metras13/EGBLE/app/src/components/ware1.png

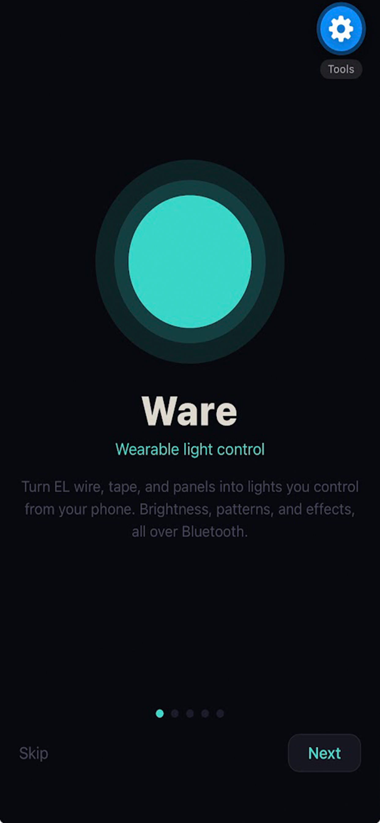
app/src/components/ware1.png
