metras13/EGBLE/app/src/components/ware2.png

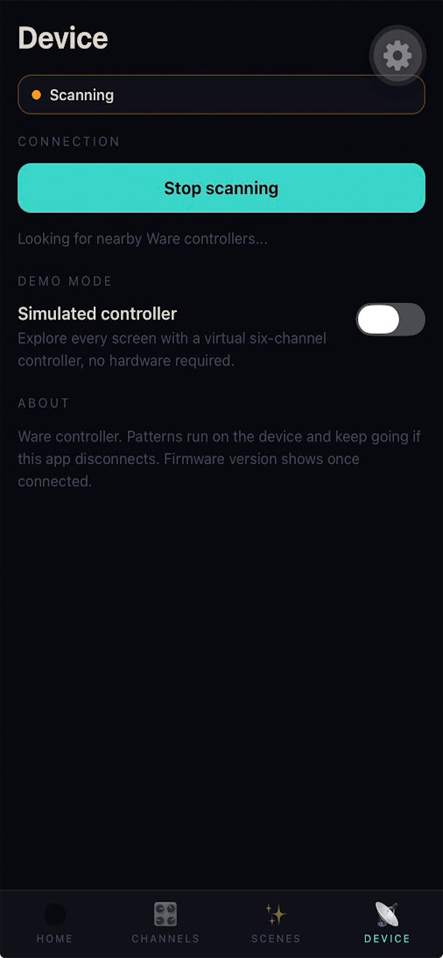
app/src/components/ware2.png
