metras13/EGBLE/app/src/components/ware3.png

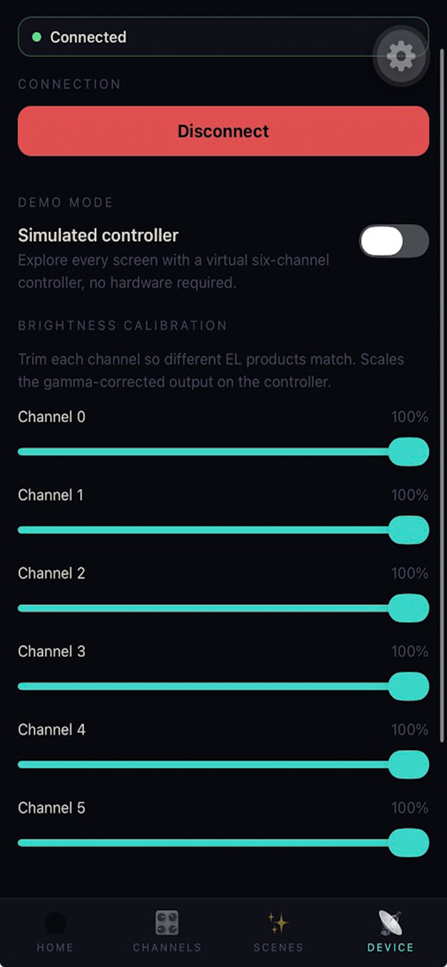
app/src/components/ware3.png
