metras13/EGBLE/app/src/components/ware4.png

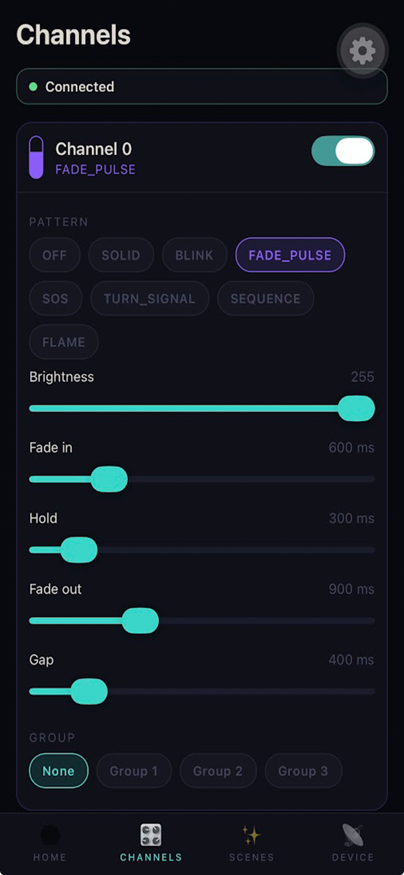
app/src/components/ware4.png
