metras13/EGBLE/app/src/components/ware5.png

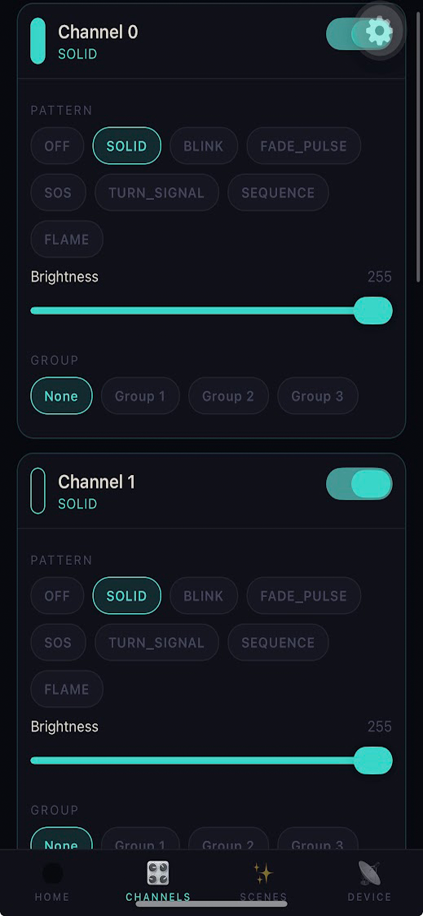
app/src/components/ware5.png
