metras13/EGBLE/app/src/components/ware6.png

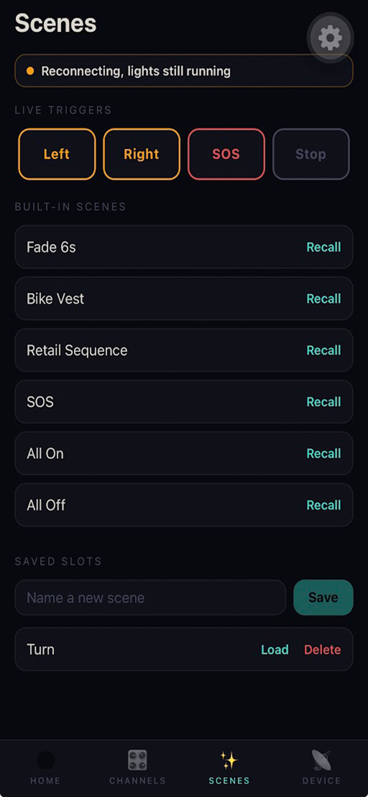
app/src/components/ware6.png
