metras13/EGBLE/(commit log)

2026-07-10 Initial commit: EGBLE 6-channel EL inverter controller
    Firmware (Arduino-ESP32, ESP32-C3-Zero), React Native (Expo) BLE app, and
    hardware/protocol docs for the 6-channel EL inverter dimmer/controller.
    Firmware (Phases 1-4):
    - LEDC 10-bit PWM channel driver with mandatory gamma correction and a
    per-channel calibration scale
    - Data-driven pattern engine: OFF, SOLID, BLINK, FADE_PULSE, SOS,
    TURN_SIGNAL, SEQUENCE, each a non-blocking per-channel state machine
    - Runtime channel enable/disable and grouping; SEQUENCE chases a group
    - Scene system persisted to NVS with five built-ins
    - BLE GATT service (command/state/scene) over NimBLE, compact JSON protocol
    - USB serial console for bench testi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
    [BleService.cpp, BleService.h, Channel.cpp, Channel.h, Pattern.cpp, Pattern.h, PatternEngine.cpp, PatternEngine.h]
2026-07-10 Add root .gitignore
    Ignore OS, editor, Python bytecode, and Arduino build artifacts at the repo
    root. The app keeps its own .gitignore for node/Expo output.
    Claude-Session: https://claude.ai/code/session_01FUi6Qdqy98eBmAS2bnUoQV
2026-07-10 Add Fade 6s bench test: 6s on-to-off fade, boot default, runbook
    First bench-bring-up target: a six second fade on to off on the real
    inverter.
    Firmware:
    - New "Fade 6s" built-in scene: every channel snaps to full and fades to off
    over 6000 ms through the gamma ramp, repeating. Confirms PWM, gamma, MOSFET
    and inverter together.
    - Board now boots into Fade 6s so the first bench test needs no phone. Also
    surfaces automatically as the first built-in in the app's Scenes list and is
    triggerable over serial with the new `fade` command.
    App:
    - Add eas.json with a development-client build profile so the app can be sent
    to Expo / EAS for on-device testing.
    Docs:
    - docs/bench-bringup.md: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
    [Scenes.cpp, SerialConsole.cpp, egble-controller.ino]
2026-07-10 Add single-channel bench wiring diagram
    SVG showing the Stage 1 wiring: ESP32 GPIO3 to the MOSFET gate through a
    100 ohm resistor, 10k gate-to-ground pulldown, low-side switching of the
    inverter ground return, and the common ground tying the bench supply,
    MOSFET source, pulldown and ESP32 together. Referenced from the bench
    bring-up runbook.
    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
2026-07-10 Document ESP32-C3 SuperMini compatibility
    The build is pin-compatible with both the Waveshare C3-Zero and the Teyleten /
    generic C3 SuperMini: all six PWM pins (3,4,5,6,7,10) and the trigger pin (1)
    are broken out on both, and the avoided strapping pins happen to be the
    SuperMini's onboard LED (GPIO8) and BOOT button (GPIO9). Note the SuperMini
    download-mode key combo for flashing and its weaker antenna. No pin changes.
    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
    [config.h]
2026-07-11 Document FQP30N06L as the verified bench MOSFET
    Capture the logic-level TO-220 option the build is using: FQP30N06L (60V/32A,
    hugely overrated for an EL inverter so it runs cold, and easier to hand-wire
    than SOT-23). Records the TO-220 pinout (1=Gate, 2=Drain and tab, 3=Source) in
    the BOM, per-channel circuit notes, bench runbook, and wiring diagram. Also
    loosen the gate pulldown spec to 10k-47k so an on-hand 12.5k qualifies.
    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
2026-07-11 Document powering the ESP32
    Add a "Powering the ESP32" subsection to the power path notes: bench setup
    (ESP32 on USB, inverters on the bench supply, common ground), the two options
    for a finished build (own USB vs sharing the 5V rail into the SuperMini 5V pin),
    and the one-source-at-a-time gotcha (USB 5V and the 5V pin are tied on most
    SuperMini boards, so do not power both at once).
    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
2026-07-11 Fix build: include <stddef.h> in Scenes.h for size_t
    Scenes.h declares slotName(..., size_t) but only included <stdint.h>, so
    size_t was undeclared when the header was pulled in ahead of any stddef,
    breaking the Arduino build with "'size_t' has not been declared". Include
    <stddef.h> directly in the header that uses it.
    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
    [Scenes.h]
2026-07-11 Fix BLE crash loop: migrate to NimBLE-Arduino 2.x API
    On esp32 core 3.x, pairing the firmware with NimBLE 1.4.x links but panics at
    boot: the BLE controller and host disagree on version ("fadebead VERSION"
    mismatch) and the board hits an instruction access fault in a reboot loop.
    Move BleService to the NimBLE 2.x API, which is the line that matches core 3.x:
    - Callback signatures take NimBLEConnInfo (onWrite) and NimBLEConnInfo + reason
    (onConnect/onDisconnect).
    - setScanResponse renamed to enableScanResponse.
    - Drop the setPower(ESP_PWR_LVL_*) call; 2.x takes dBm, and the default is fine.
    Docs and the sketch header now specify NimBLE-Arduino 2.x and explain the crash
    signature so it is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
    [BleService.cpp, egble-controller.ino]
2026-07-11 Make Fade 6s a symmetric breathe (3s up, 3s down)
    Bench-verified the snap-on plus fade-out worked; switch the default bench scene
    to a symmetric breathe so the gamma ramp is checked in both directions. Six
    second cycle: fadeInMs 3000, fadeOutMs 3000. Docs updated to match.
    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
2026-07-11 Advertise the BLE name explicitly; record measured inverter current
    NimBLE-Arduino 2.x does not auto-add the device name to the advertisement the
    way 1.4.x did, so the controller was advertising its service UUID but no
    readable name and did not show as "EGBLE-Controller" in scanners. Call
    NimBLEAdvertising::setName so the name lands in the scan response (the 128-bit
    service UUID already fills the primary advertising packet).
    Also record the Phase 1 bench measurement in the BOM: about 40 mA per inverter
    at peak, ~0 mA off, so roughly 240 mA for six channels and a 5V 1A supply is
    ample.
    Claude-Session: https://claude.ai/code/session_01F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
2026-07-11 Fix EAS install: pin react-dom to react's version
    npm floated react-dom to 19.2.7 (pulled in transitively via expo-router web
    deps), which demands react ^19.2.7 while the project pins react 19.2.0, so EAS
    `npm ci` failed with ERESOLVE. Pin react-dom to 19.2.0 to match react (its peer
    is react ^19.2.0, satisfied), and add app/.npmrc with legacy-peer-deps=true as a
    safety net against future transitive peer drift on the strict CI install. The
    app is iOS-only, so react-dom is not used at runtime regardless.
    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
2026-07-11 Force react-dom to 19.2.0 with an npm override
    The direct react-dom pin was not enough on its own because EAS runs `npm ci`,
    which installs from the committed package-lock.json and ignores package.json.
    Add an "overrides" entry so react-dom resolves to 19.2.0 tree-wide whenever the
    lockfile is regenerated, defeating the transitive pull of react-dom 19.2.7 from
    expo-router's web deps. The lockfile still has to be regenerated and committed
    for npm ci to pick it up.
    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
2026-07-11 Commit verified package-lock.json (react-dom pinned 19.2.0)
    Generate and commit the lockfile so EAS `npm ci` installs a known-good tree
    instead of re-resolving react-dom to 19.2.7. Verified in a clean environment:
    `npm ci --dry-run --legacy-peer-deps=false` (strict peer resolution, the EAS
    worst case) succeeds with no ERESOLVE, and react-dom resolves to 19.2.0.
    Pull this branch and rebuild; no local regeneration needed.
    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
2026-07-11 Add 6-channel wiring guide and Phase 3 bring-up checklist
    Bus-style diagram (docs/wiring-6-channel.svg): one shared 5V supply and one
    common ground feeding six repeats of the proven single-channel block on GPIO
    3/4/5/6/7/10. Add a Stage 3 checklist to the bench runbook covering the pin map,
    supply sizing (~240 mA), grouping/SEQUENCE test commands, and what to watch for
    (EMI/brownout with all six switching). No firmware changes needed; six channels,
    grouping and SEQUENCE are already supported.
    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
2026-07-11 Rebrand to Ware; add Orb home with presets and a Channels tab
    Ware (a play on "wear", for wearables) is the app-facing brand; the BLE device
    name and repo stay EGBLE to avoid a reflash.
    - New Home screen: a large orb as the master control (tap to turn on/off), a
    brightness slider to dim, and Steady/Flame/Strobe/Fade presets each with a
    speed slider. Flame maps to the new FLAME pattern, Strobe to BLINK, Fade to
    FADE_PULSE. Orb state is derived from device notifications, not local guesses.
    - Move the per-channel dashboard to its own Channels tab; tabs are now
    Home / Channels / Scenes / Device.
    - Store: add persisted masterBrightness, channelCount, and onboarded prefs plus
    a setAllPa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
2026-07-13 Fix EL fade-in pop with a calibrated output floor
    EL inverters start oscillating at a higher drive than they sustain (measured on
    this inverter: start ~187, sustain ~145 of 1023). Below the start threshold a
    fade-in stays dark then pops on, while fade-out stays lit down to the lower
    sustain level and looks smooth. Same ramp, asymmetric light.
    Remap any lit output into [OUTPUT_FLOOR_DUTY, PWM_MAX_DUTY] (floor default 200,
    just above the measured start threshold) in Channel::setBrightness, preserving
    the gamma shape. The dimmest visible drive now clears the start threshold, so
    fade-ins begin just-visible and ramp smoothly. Level 0 stays fully off. The
    floor is a config constant, tunable per i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
    [Channel.cpp, config.h]
2026-07-13 Tune fade-in for EL: gamma 2.0 and a slightly lower output floor
    The fade-in still held dim then rushed up because gamma 2.2 is calibrated for
    LEDs (linear duty-to-brightness), while EL inverters brighten steeply near the
    threshold then flatten. Regenerate the gamma table at 2.0 (softer low end) so a
    linear level ramp reads as an even fade on EL, and lower OUTPUT_FLOOR_DUTY from
    200 to 195 so the ramp starts a touch dimmer while still clearing the 187 start
    threshold. Both are documented as tunable dials: gamma via gen_gamma.py, floor
    in config.h.
    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
2026-07-14 Clarify 6-channel wiring: drains are separate from the common ground
    The original 6-channel diagram made all six drops converge at the bottom, which
    reads as "all grounds tied together" and led to inverter V- returns being landed
    on the common ground rail, bypassing the MOSFETs and leaving every channel stuck
    on. Redraw so each inverter V- to MOSFET drain segment is a distinct color
    (orange, switched return, one node per channel) versus the black common ground
    (sources + supply minus + ESP32 GND only), add V+/V-/D/S labels, and a bold
    warning that drains must never touch the ground rail or each other. Same warning
    added to the Phase 3 checklist.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
2026-07-27 Package Ware for App Store submission
    Production app config and assets:
    - App icon (1024, glowing teal orb on dark, matching the Home orb), Android
    adaptive icon, and a dark splash via expo-splash-screen.
    - app.json set to production: name Ware, version 1.0.0, iOS buildNumber 1,
    Android versionCode 1, icon/splash wired up, Ware-branded Bluetooth usage
    strings, export-compliance flag already false.
    - Add expo-splash-screen dependency and regenerate the lockfile (npm ci verified
    clean under strict peer resolution).
    - SUBMISSION.md: build/submit commands, App Store Connect metadata, screenshots,
    App Privacy answers, version bumps, and the Bluetooth-companion review risk
    (Guideline 2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
2026-07-27 Add Demo Mode and onboarding walkthrough
    Demo Mode: an in-app simulator (demoController) that speaks the same JSON command
    protocol as the firmware, keeps six channels of fake state, and animates their
    levels so every screen works with no hardware. The store swaps between the real
    BLE controller and the demo backend transparently via active(). This lets a
    first-time user (and an App Review tester) explore the whole app, and makes
    screenshots easy. Toggle on the Device tab or from onboarding.
    Onboarding: a first-launch walkthrough (gated by the persisted onboarded flag,
    with a hydration guard so returning users do not flash it). Covers what Ware is,
    the use cases (wearables, remote, sequenci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
2026-09-10 Add battery indicator + wear-mode features; fix App Store name (Ware)
    Fixes the two App Store review items and adds wearer-facing controls.
    App Store rejection fixes:
    - 2.3.8 Accurate Metadata: build manifest name is now "Ware" (was "EGBLE"),
    so the device display name matches the marketplace listing. Restored the
    app icon / splash and kept the EAS build wiring (projectId, owner, updates).
    - 2.1 App Completeness: REVIEW-NOTES.md gives the App Store Connect reviewer
    notes (test the whole app via Demo mode, no login) plus a demo-video shot list.
    Features:
    - Battery indicator: parses optional bat:{p,ch} state field, white/orange/red
    tiers, low-battery banner. Demo mode simulates a dra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
2026-09-10 Add Ware marketing landing page (App Store marketing URL)
    Ellumiglow-branded landing page for the Ware app, cloned from the mood-landing
    design and re-skinned (scoped wl- classes so it will not collide with the live
    mood-landing page). Standalone HTML; the block between the SHOPIFY SECTION
    markers pastes into a Shopify page at /pages/ware-landing. Fill APP_STORE_URL
    once the app is live.
2026-09-10 Convert Ware landing page to a Shopify section (ware-landing.liquid)
    Replaces the standalone HTML with a self-contained Shopify section matching
    the mood-landing.liquid pattern: schema-driven hero (eyebrow, two title lines,
    subtitle) and an App Store URL setting. The download button auto-hides via
    {% if section.settings.app_store_url != blank %} until the app is live.
    Scoped wl- classes / .ware-landing wrapper avoid collisions with mood-landing.
2026-09-10 Add ware-landing.liquid (restore marketing page as Shopify section)
    The prior commit removed the HTML but the liquid file failed to stage, leaving
    the page missing from main. This adds the Shopify section file.
